Overengineering-squared/Overengineering-squared-RoboCup/(threads)

Thread 1 (2024-10-18):

CODEX

Navya-web618, 2024-10-18:
hello!
Inspired by watching your previous runs we wanted to ask you some questions and tips for our first season participating in robocup, we have qualified for robocup Asia-Pacific.

Ques-1) we are using machine learning for the rescue mission, but we are not using a torch. Till now we haven't faced any problems but according to you are there any problems that might occur?
Ques-2) This is our first season doing robocup, what are some problems that we might face ?
Ques-3) In the Resvue Mission, is there any chance that the ball might be touching a wall or the triangles?

Skillnoob, 2024-10-18:
1. Do you mean pytorch or our LED's?
2. If you qualify for higher tournaments you should expect tiles you may haven't seen before. If you go through our videos from this year, you will see that the tiles got increasingly more complex. For example at the world championship there were green markers on ramps and obstacles on the ramp.
You should also bring spare parts for **everything** (except maybe really big parts), you never know what might break.
If you are using something like a Raspberry Pi or other SBC's. **Make a backup of the OS.**
3. Yes, that will always be the case. Usually the victims are placed roughly around the center of the evacuation zone, but your robot can obviously move them in inconvinient positions.

In general, I would reccomend having your code on a github respository, so you can easily roll back a change using GIT (you can google how to) if something went horribly wrong.

Navya-web618, 2024-10-18:
Another question -
is it allowed to you to place checkpoint wherever you want or the organisers place them themselves,
Also will, network will be provided by the organisers

Thank you

Navya-web618, 2024-10-18:
I have another question which I have put on you Github page issue,
Waiting for your reply

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

Skillnoob, 2024-10-18:
The organizers decide where to place the checkpoints, so its equal for everyone.
What do you mean by network? If you're talking about WIFI, we purchased a SIM Card Router and a sim card with unlimited data in the country we went to. It depends on the location if you get free WIFI by the organizers.

Closed 2024-11-28.

Thread 2 (2024-12-13):

Lucmar

Vincenzo220806, 2024-12-13:
Hello guys, we are always the lucmar team. we found a problem, the transition from raspberry pi4 to raspberry pi5 . doesn’t make us install any libraries like cv2 or gpio zero . what could it be?
we are waiting for answer

Team Lucmar.

Closed 2024-12-13.

Thread 3 (2025-01-26):

ask for colar

Vincenzo220806, 2025-01-26:
Good morning guys, we are Lucmar's team to write. We had a doubt while working on the robot. As you know we appreciated your choice to use the collar and raspberry pi5 together we also used it. it is a problem that occurs by installing the libraries to use the camera as picamere 2 within the virtual environment created for the colar using python 3.9. It is not possible to see the desired image window, even with the cv.imshow command. All the ai works for us and the only thing we lack is this image preview. In the forum we saw that you need a library called PyQt05 very difficult to install. Have you encountered these problems, how did you solve them? Thank you very much for the answer the Lucmar team

Skillnoob, 2025-01-26:
Are you using Ultralytics?

Vincenzo220806, 2025-01-26:
yes we tried to use ultralytics but we can’t get real time frames provided that for the acquisition of the images we use picamera2

Skillnoob, 2025-01-26:
If you are using ultralytics for inference, you can add `show=True` to the `model()` or `model.predict()`.

Vincenzo220806, 2025-01-26:
> If you are using ultralytics for inference, you can add `show=True` to the `model()` or `model.predict()`.

Obviously, however we needed picamera2 and opencv to intervene on the frame and understand the position of the detected objects, furthermore if in the same code we insert import picamera2 to use it for other functions external to ultralytics that we need, the object detection does not start, this is because picamera2 inside the virtual environments is not compatible with the gui windows due to the lack of PyQT5 which is difficult to install in the venv because it crashes the raspberry 5. Is it therefore possible to install ultralytics and silvatpu globally on the raspberry (therefore in turn installing python 3.9 globally), so as to be able to integrate picamera2 which works outside the venv?

Skillnoob, 2025-01-26:
I have no idea what you are talking about, your wording is very confusing.
You can simply supply the frame from picamera2 to ultralytics and then let it process the image, the argument i provided earlier just shows the processed result.
Also, why python 3.9? You should probably upgrade to raspberry pi os bookworm, which ships with python 3.11.

Vincenzo220806, 2025-01-26:
> I have no idea what you are talking about, your wording is very confusing.
> You can simply supply the frame from picamera2 to ultralytics and then let it process the image, the argument i provided earlier just shows the processed result.
> Also, why python 3.9? You should probably upgrade to raspberry pi os bookworm, which ships with python 3.11

The package edge-tpu-silva is only compactible with python versions <3.10, for this i installed silvatpu on a virtual environment with python 3.9. In my question i meant to say that if in the same code i need to use picamera2 for other functions, just by writing “import picamera2” the object detection silvantpu does not start.

Skillnoob, 2025-01-26:
edge-tpu-silva? I have never heard of that before.
You should follow this guide, you don't need that package:
https://docs.ultralytics.com/guides/coral-edge-tpu-on-raspberry-pi/

Vincenzo220806, 2025-01-28:
Following the guide gives me the following error, would you be able to understand what the problem is? WARNING ⚠️ Unable to automatically guess model task, assuming 'task=detect'. Explicitly define task for your model, i.e. 'task=detect', 'segment', 'classify','pose' or 'obb'.
Loading ball_detect_s_edgetpu.tflite on device 0 for TensorFlow Lite Edge TPU inference...
Traceback (most recent call last):
  File "/home/raspberry/TPU/myenv/lib/python3.11/site-packages/tensorflow/lite/python/interpreter.py", line 166, in load_delegate
    delegate = Delegate(library, options)
  File "/home/raspberry/TPU/myenv/lib/python3.11/site-packages/tensorflow/lite/python/interpreter.py", line 104, in __init__
    raise ValueError(capture.message)
ValueError

During handling of the above exception, another exception occurred:

Traceback (most recent call last):
  File "/home/raspberry/TPU/yolo.py", line 21, in <module>
    results = model(frame)
  File "/home/raspberry/TPU/myenv/lib/python3.11/site-packages/ultralytics/engine/model.py", line 180, in __call__
    return self.predict(source, stream, **kwargs)
  File "/home/raspberry/TPU/myenv/lib/python3.11/site-packages/ultralytics/engine/model.py", line 551, in predict
    self.predictor.setup_model(model=self.model, verbose=is_cli)
  File "/home/raspberry/TPU/myenv/lib/python3.11/site-packages/ultralytics/engine/predictor.py", line 310, in setup_model
    self.model = AutoBackend(
  File "/home/raspberry/TPU/myenv/lib/python3.11/site-packages/torch/utils/_contextlib.py", line 116, in decorate_context
    return func(*args, **kwargs)
  File "/home/raspberry/TPU/myenv/lib/python3.11/site-packages/ultralytics/nn/autobackend.py", line 397, in __init__
    experimental_delegates=[load_delegate(delegate, options={"device": device})],
  File "/home/raspberry/TPU/myenv/lib/python3.11/site-packages/tensorflow/lite/python/interpreter.py", line 168, in load_delegate
    raise ValueError('Failed to load delegate from {}\n{}'.format(
ValueError: Failed to load delegate from libedgetpu.so.1

Skillnoob, 2025-01-28:
What libedgetpu did you install

Vincenzo220806, 2025-01-28:
> What libedgetpu did you install

I did install libedgetpu-max-arm64.deb

Skillnoob, 2025-02-09:
Alright, I'm closing this issue since you are spamming this all over the ultralytics issues and discussions.

Closed 2025-02-09.

Thread 4 (2025-02-09):

ask for colar

Vincenzo220806, 2025-02-09:
hi I followed this video: https://youtu.be/lJRLzXf7EVs?si=NnPgkaUit1Bavr-4 to use the coral usb acceleretor in real time on my raspberry pi5 but I can't use the cam with the flat by downloading the picamera2 library in my virtual environment thonny tells me that it can't find the libcamera package but as soon as I write "libcamera-hello" on the virtual environment terminal I can easily use the cam I also tried to give access to the system packages with: "--system-site-packages" but I still can't solve the problem could someone help me

Skillnoob, 2025-02-11:
Stop spamming this everywhere.

Closed 2025-02-11.

Thread 5 (2025-03-22):

Ultralytics Problems

lucmar56, 2025-03-22:
Hello! We are a Rescue Line team and I saw that you also use coral with the raspberry 5 and for this reason I wanted to create a comparison with you to get feedback on a problem we had. We install myenv ultralytics in a virtual environment, we also install the tflite-runtime that you have put in your repository, and we do the same with libegdgetpu1-max. All installations are successful, but when we start the inference with an edgetpu.tflite file an error comes out. I attach the code and the error and I hope you can help me in this, thank you I await answer!

CODE:
import cv2
from picamera2 import Picamera2
from ultralytics import YOLO

# Set up the camera with Picam
picam2 = Picamera2()
picam2.preview_configuration.main.size = (640, 480)
picam2.preview_configuration.main.format = "RGB888"
picam2.preview_configuration.align()
picam2.configure("preview")
picam2.start()

# Load YOLOv8
model = YOLO("/home/utente/Scaricati/ball_detect_s_edgetpu.tflite")

while True:
    # Acquisisce un frame dalla fotocamera
    frame = picam2.capture_array()

    # Esegue YOLO sul frame
    results = model(frame)

    # Ottiene il frame annotato
    annotated_frame = results[0].plot()
    center=(0,0)
    # Estrai bounding boxes
    for box in results[0].boxes.xyxy:
        x_min, y_min, x_max, y_max = map(int, box)  # Converte in interi
        center_x = (x_min + x_max) // 2
        center_y = (y_min + y_max) // 2
        center=(center_x, center_y)

        # Disegna il centro dell'oggetto
    cv2.circle(annotated_frame, center, 5, (0, 255, 0), -1)

    inference_time = results[0].speed['inference']
    fps = 1000 / inference_time  # Converti in FPS
    text = f'FPS: {fps:.1f}'

    # Disegna FPS
    font = cv2.FONT_HERSHEY_SIMPLEX
    text_size = cv2.getTextSize(text, font, 1, 2)[0]
    text_x = annotated_frame.shape[1] - text_size[0] - 10
    text_y = text_size[1] + 10
    cv2.putText(annotated_frame, text, (text_x, text_y), font, 1, (255, 255, 255), 2, cv2.LINE_AA)

    # Mostra il frame
    cv2.imshow("Camera", annotated_frame)

    # Esci premendo "q"
    if cv2.waitKey(1) == ord("q"):
        rilascia()
        stop()
        break

# Close all windows
cv2.destroyAllWindows()

ERROR:
Loading /home/utente/Scaricati/ball_detect_s_edgetpu.tflite on device 0 for TensorFlow Lite Edge TPU inference...
Traceback (most recent call last):
  File "/home/utente/coral/lib/python3.11/site-packages/tflite_runtime/interpreter.py", line 166, in load_delegate
    delegate = Delegate(library, options)
  File "/home/utente/coral/lib/python3.11/site-packages/tflite_runtime/interpreter.py", line 104, in __init__
    raise ValueError(capture.message)
ValueError

During handling of the above exception, another exception occurred:

Traceback (most recent call last):
  File "/home/utente/coral/inferenza.py", line 22, in <module>
    results = model(frame)
  File "/home/utente/coral/lib/python3.11/site-packages/ultralytics/engine/model.py", line 182, in __call__
    return self.predict(source, stream, **kwargs)
  File "/home/utente/coral/lib/python3.11/site-packages/ultralytics/engine/model.py", line 543, in predict
    self.predictor.setup_model(model=self.model, verbose=is_cli)
  File "/home/utente/coral/lib/python3.11/site-packages/ultralytics/engine/predictor.py", line 378, in setup_model
    self.model = AutoBackend(
  File "/home/utente/coral/lib/python3.11/site-packages/torch/utils/_contextlib.py", line 116, in decorate_context
    return func(*args, **kwargs)
  File "/home/utente/coral/lib/python3.11/site-packages/ultralytics/nn/autobackend.py", line 414, in __init__
    experimental_delegates=[load_delegate(delegate, options={"device": device})],
  File "/home/utente/coral/lib/python3.11/site-packages/tflite_runtime/interpreter.py", line 168, in load_delegate
    raise ValueError('Failed to load delegate from {}\n{}'.format(
ValueError: Failed to load delegate from libedgetpu.so.1

Thread 6 (2025-09-16):

3D sketch drawings

chuthaianh, 2025-09-16:
Dear Overengineering² team,
I am doing research about a mobile robot using a camera to detect obstacles on the lines. I found yours really impressive. I want to ask about the 3D sketch and the way how you designed your robot. Please, if possible, can I direct message you?
Sincerely, Thank you!

chuthaianh, 2025-09-16:
What is the reason you don't use a controller in motor control? Since I don't see any controller in your robot_v.3/Arduino/arduino_main/arduino_main.ino .

Skillnoob, 2025-09-16:
If we used the Arduino to control the motors we would have to have some more advanced communication from pi -> arduino which we want to avoid. The 3.3V of the GPIO pins is enough to drive the "5V" speed control of the motor controller.

Skillnoob, 2025-09-16:
You can find the controller in the readme.

chuthaianh, 2025-09-16:
Thank you!

Skillnoob, 2025-09-16:
But in general you can find all the control code in https://github.com/Overengineering-squared/Overengineering-squared-RoboCup/blob/main/robot_v.3/Python/main/control.py
